richardeoin/happytuesdays/hardware/happytuesdays.brd

## EAGLE design hardware/happytuesdays.brd (2015-03-13)

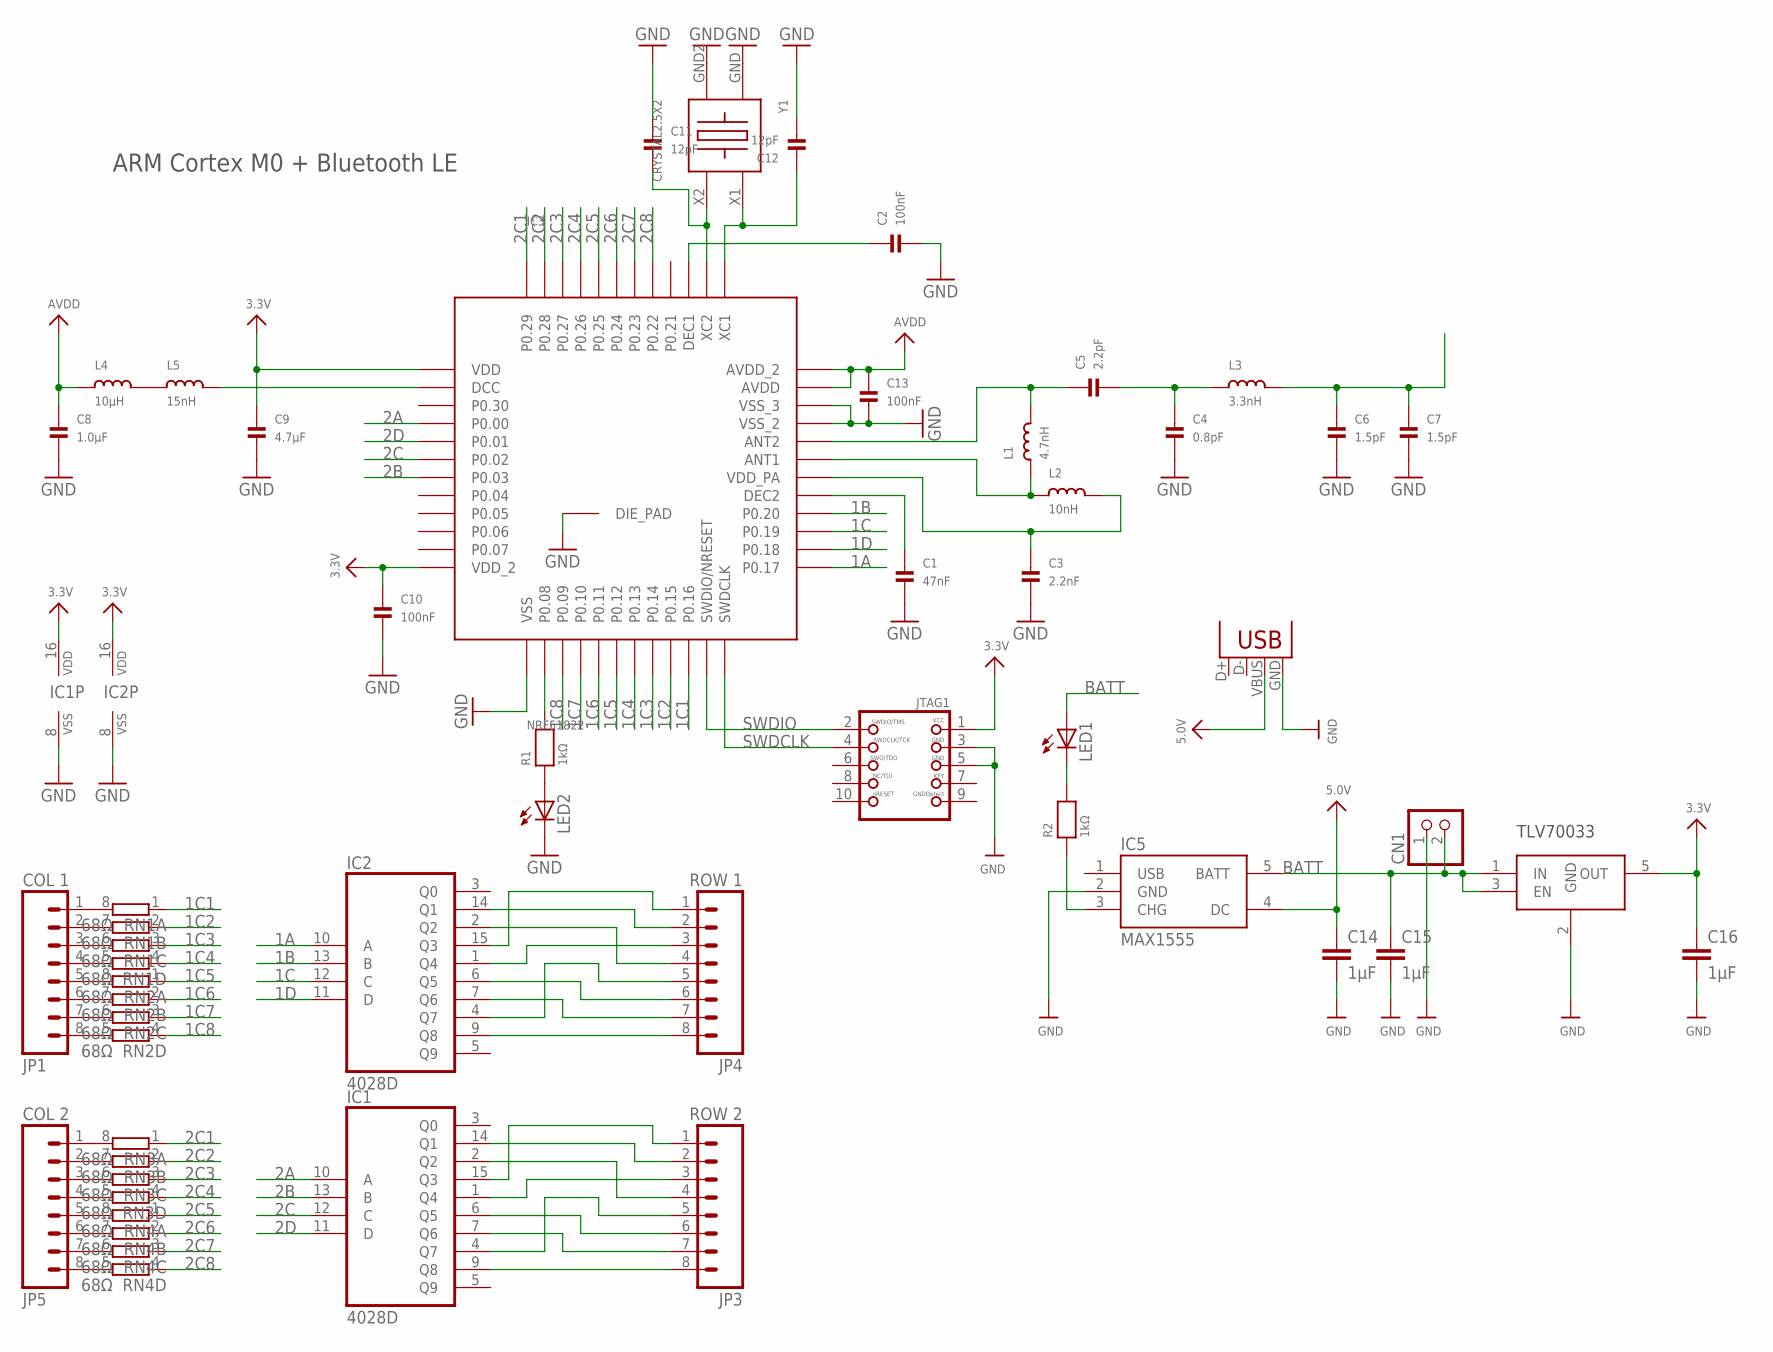
[picture p1: schematic happytuesdays.sch]

Parts:
C1: 47nF; _0402
C2, C10, C13: 100nF; _0402
C3: 2.2nF; _0402
C4: 0.8pF; _0402
C5: 2.2pF; _0402
C6, C7: 1.5pF; _0402
C8: 1.0µF; _0402
C9: 4.7µF; _0402
C11, C12: 12pF; _0402
C14, C15, C16: 1µF; C0603K
CN1: JST_2PIN; JSTPH2
IC1, IC2: 4028D; SO16
IC3: NRF51822; QFN48
IC4: TLV70033DCK; SC70-5L
IC5: MAX1555; SOT23-5
JP1: COL 1; 1X08_LOCK
JP3: ROW 2; 1X08_LOCK
JP4: ROW 1; 1X08_LOCK
JP5: COL 2; 1X08_LOCK
JTAG1: JTAG-CORTEXM3SMT; 2X05_1.27MM_SMT
L1: 4.7nH; _0402
L2: 10nH; _0402
L3: 3.3nH; _0402
L4: 10µH; _0402
L5: 15nH; _0402
LED1, LED2: LEDCHIPLED_0603; CHIPLED_0603
R1, R2: 1kΩ; _0402
RN1, RN2, RN3, RN4: 68Ω; 4X0402ARV341
X1: USB-MICROB
Y1: CRYSTAL2.5X2; 2.5X2MM

Connections:
1A: IC2.10 (A), IC3.25 (P0.17)
1B: IC2.13 (B), IC3.28 (P0.20)
1C: IC2.12 (C), IC3.27 (P0.19)
1C1: IC3.22 (P0.16), RN1.1
1C1R: JP1.1, RN1.8 (2)
1C2: IC3.21 (P0.15), RN1.2 (1)
1C2R: JP1.2, RN1.7 (2)
1C3: IC3.20 (P0.14), RN1.3 (1)
1C3R: JP1.3, RN1.6 (2)
1C4: IC3.19 (P0.13), RN1.4 (1)
1C4R: JP1.4, RN1.5 (2)
1C5: IC3.18 (P0.12), RN2.1
1C5R: JP1.5, RN2.8 (2)
1C6: IC3.17 (P0.11), RN2.2 (1)
1C6R: JP1.6, RN2.7 (2)
1C7: IC3.16 (P0.10), RN2.3 (1)
1C7R: JP1.7, RN2.6 (2)
1C8: IC3.15 (P0.09), RN2.4 (1)
1C8R: JP1.8, RN2.5 (2)
1D: IC2.11 (D), IC3.26 (P0.18)
1Q1: IC2.14 (Q1), JP4.2
1Q2: IC2.2 (Q2), JP4.4
1Q3: IC2.15 (Q3), JP4.1
1Q4: IC2.1 (Q4), JP4.3
1Q5: IC2.6 (Q5), JP4.6
1Q6: IC2.7 (Q6), JP4.7
1Q7: IC2.4 (Q7), JP4.5
1Q8: IC2.9 (Q8), JP4.8
2A: IC1.10 (A), IC3.4 (P0.00)
2B: IC1.13 (B), IC3.7 (P0.03)
2C: IC1.12 (C), IC3.6 (P0.02)
2C1: IC3.48 (P0.29), RN3.1
2C1R: JP5.1, RN3.8 (2)
2C2: IC3.47 (P0.28), RN3.2 (1)
2C2R: JP5.2, RN3.7 (2)
2C3: IC3.46 (P0.27), RN3.3 (1)
2C3R: JP5.3, RN3.6 (2)
2C4: IC3.45 (P0.26), RN3.4 (1)
2C4R: JP5.4, RN3.5 (2)
2C5: IC3.44 (P0.25), RN4.1
2C5R: JP5.5, RN4.8 (2)
2C6: IC3.43 (P0.24), RN4.2 (1)
2C6R: JP5.6, RN4.7 (2)
2C7: IC3.42 (P0.23), RN4.3 (1)
2C7R: JP5.7, RN4.6 (2)
2C8: IC3.41 (P0.22), RN4.4 (1)
2C8R: JP5.8, RN4.5 (2)
2D: IC1.11 (D), IC3.5 (P0.01)
2Q1: IC1.14 (Q1), JP3.2
2Q2: IC1.2 (Q2), JP3.4
2Q3: IC1.15 (Q3), JP3.1
2Q4: IC1.1 (Q4), JP3.3
2Q5: IC1.6 (Q5), JP3.6
2Q6: IC1.7 (Q6), JP3.7
2Q7: IC1.4 (Q7), JP3.5
2Q8: IC1.9 (Q8), JP3.8
3.3V: C9.1, C10.1, C16.1, IC1.16 (VDD), IC2.16 (VDD), IC3.1 (VDD), IC3.12 (VDD_2), IC4.5 (OUT), JTAG1.1
5.0V: C14.1, IC5.4 (DC), X1.VBUS
ANT: C6.1, C7.1, L3.2
ANT1: IC3.31 (ANT1), L1.1, L2.1
ANT2: C5.1, IC3.32 (ANT2), L1.2
AVDD: C8.1, C13.1, IC3.35 (AVDD), IC3.36 (AVDD_2), L4.1
BATT: C15.1, CN1.2, IC4.1 (IN), IC4.3 (EN), IC5.5 (BATT), LED1.A
CHG: IC5.3 (CHG), R2.1
DCC: IC3.2 (DCC), L5.2
DEC1: C2.1, IC3.39 (DEC1)
DEC2: C1.1, IC3.29 (DEC2)
GND: C1.2, C2.2, C3.2, C4.2, C6.2, C7.2, C8.2, C9.2, C10.2, C11.1, C12.2, C13.2, C14.2, C15.2, C16.2, CN1.1, IC1.8 (VSS), IC2.8 (VSS), IC3.13 (VSS), IC3.33 (VSS_2), IC3.34 (VSS_3), IC3.GND (DIE_PAD), IC4.2 (GND), IC5.2 (GND), JTAG1.3, JTAG1.5, LED2.C, X1.GND, Y1.GND, Y1.GND2
LED: LED1.C, R2.2
unnamed: L4.2, L5.1
unnamed: IC3.14 (P0.08), R1.2
unnamed: LED2.A, R1.1
SWDCLK: IC3.24 (SWDCLK), JTAG1.4
SWDIO: IC3.23 (SWDIO/NRESET), JTAG1.2
UNBAL: C4.1, C5.2, L3.1
VDD_PA: C3.1, IC3.30 (VDD_PA), L2.2
X1: C12.1, IC3.37 (XC1), Y1.X1
X2: C11.2, IC3.38 (XC2), Y1.X2

Notes on the sheet:
ARM Cortex M0 + Bluetooth LE
TLV70033

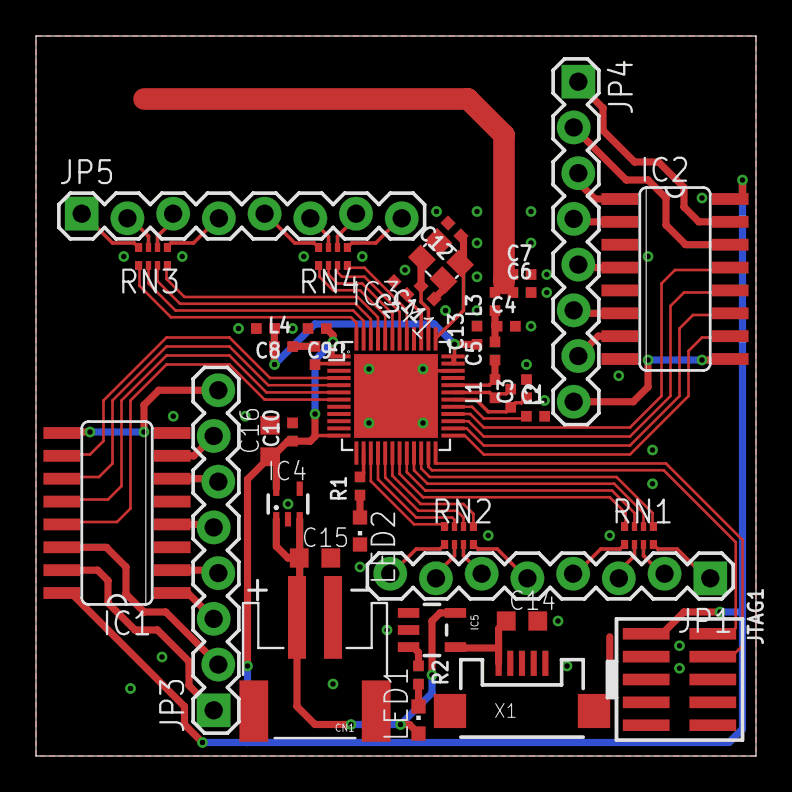
[picture p2: board happytuesdays.brd from above]

Board: 2 copper layers, 40.0 x 40.0 mm, 42 parts (0 on the bottom side), 78 nets.
