richardeoin/happytuesdays/(commit log)

2014-10-12 Initial Commit, basic board design
    [happytuesdays.brd, happytuesdays.sch]
2015-03-11 Board finished, added partslist
    [happytuesdays.brd, happytuesdays.sch]
2015-03-13 Added partlist
    [happytuesdays.brd, happytuesdays.sch]
